LovelyWhite/vst_lan_mic/site/images/product.webp

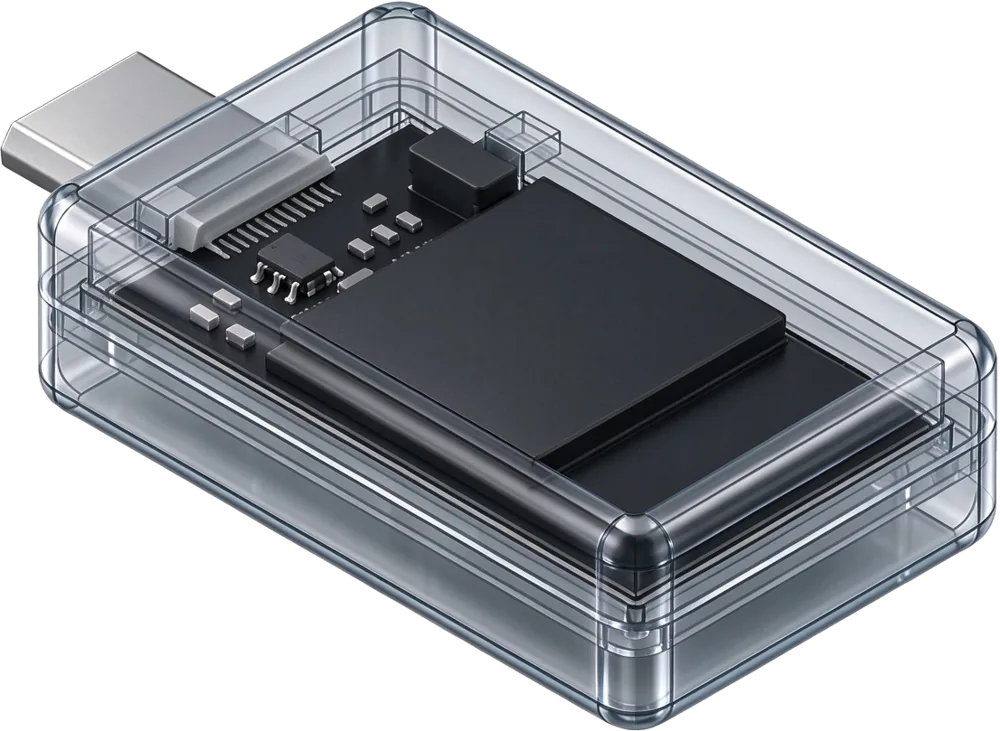
site/images/product.webp
