LovelyWhite/vst_lan_mic/docs/PROTOCOL.md

# 网络协议与线程设计

## 协议版本

唯一的 C++ 协议定义位于 `common/Protocol.h`。固件和插件直接使用同一文件；
`esp32s3/include/Protocol.h` 仅为转发头。Python 发现工具按相同格式读取。

当前版本为 **9**，不兼容版本 8。使用时必须一起更新固件与两个插件。
版本 9 将电脑到 ESP32 的上行从单声道 Opus 改为立体声（交错 L/R）Opus；
版本 8 曾把该方向从 14 ms 单声道 PCM 改为 20 ms 单声道 Opus，并删除
kind 5 Audio。两个方向现在完全同构：48 kHz、立体声（交错 L/R）、
192 kbps CBR，Opus 帧长均为 20 ms / 每声道 960 样本，使用音乐模式，
不使用 Ogg 容器。

## 数据报

所有多字节字段都显式按小端读写，不直接发送 C++ 结构体，不依赖结构体对齐或主机字节序。
固定包头 28 字节。Opus payload 为 1 至 512 字节：两个方向都是 192 kbps CBR
的 20 ms 音频，通常为 480 字节（整包 508 字节），加上 UDP/IPv4 头均远低于
1500 MTU，不需要 IP 分片。

| 偏移 | 字节 | 字段 | 说明 |
| --- | --- | --- | --- |
| 0 | 4 | magic | `0x31534f53`，线上字节为 `SOS1` |
| 4 | 1 | version | `10` |
| 5 | 1 | kind | 1 Discover、2 Offer、3 Subscribe、4 Ack、6 AudioOpus、7 Diagnostics |
| 6 | 2 | flags | Sender=1、Receiver=2、Busy=`0x8000` |
| 8 | 4 | session | 非零会话 ID，Discover 可为零 |
| 12 | 4 | sequence | 每个音频方向独立的包序号，允许自然回绕 |
| 16 | 4 | timestampMs | 发送端单调毫秒计数，允许自然回绕 |
| 20 | 4 | sampleRate | 必须是 48000 |
| 24 | 2 | payloadBytes | 必须与实际 UDP 长度完全匹配 |
| 26 | 2 | reserved | 必须为零 |
| 28 | 可变 | payload | 控制信息或裸 Opus packet |

AudioOpus 用于两个音频方向，必须 flags=0，payloadBytes 为 1 至 512。
两个方向每包都解码为每声道 960 个样本，按 L,R 交错存放（共 1920 个样本）。
Offer 必须 flags=0，负载为 1 至 64 字节 ASCII，形如 `设备标识|设备名称`，不带终止符；
两个字段都不含 `|`，以第一个 `|` 分界。
Discover、Subscribe、Ack 无负载。接收方拒绝错误版本、采样率、长度、保留字段或类型。

## 无串口设备诊断

Diagnostics 是可选扩展，不修改音频包格式。旧插件忽略 kind 7；
新插件连接旧固件时仍能传音频，但面板提示等待诊断。查看设备统计需要更新固件和
Return 插件，不要求更新 Send 插件，也不需要开启 `LANMIC_ENABLE_SERIAL`。

固件在音频发送处理之后，每秒最多从控制端口 45678 向有效 Receiver 的已登记端口
发送一包诊断。复用非阻塞 socket，不新增端口、任务或动态分配；发送失败直接跳过，
不重试、不清除租约、不计入音频发送失败。此统计仍会占用少量网络任务时间和带宽。
包头 flags=0、session=设备开机 ID，sequence 为独立诊断序号，timestampMs 为设备采样
时间，payloadBytes 必须为 64。负载为下表 16 个显式小端 32 位字段，不发送结构体内存：

| 负载偏移 | 字段 | 含义 |
| --- | --- | --- |
| 0 / 4 / 8 | captured / encoded / sent | 累计采集、编码成功、socket 发送成功帧数 |
| 12 / 16 | rawDrop / encodedDrop | 原始、编码队列入队失败次数 |
| 20 / 24 | rawTrim / encodedTrim | 原始、编码队列累计裁剪帧数 |
| 28 | encodeErrors | 累计编码错误次数 |
| 32 / 36 | sendWouldBlock / pollBlocked | 音频发送暂不可用次数、存在待发帧但 socket 不可写次数 |
| 40 | uplinkPlc | 设备解码 DAW 上行时累计补帧数，与 Return PLC 方向不同 |
| 44 / 48 | receiveWorkUs / encodeWorkUs | 收包解码处理、Opus 编码累计墙钟微秒数，包含被抢占时间 |
| 52 / 56 | rawQueued / encodedQueued | 队列帧数快照；原始队列由编码消费者采样 |
| 60 | rssiDbm | 有符号 dBm，范围 -128 至 0；-128 表示未连接 |

除队列快照和 RSSI 外，字段均为设备启动以来的无符号累计值，允许自然回绕。
收包解码处理耗时包括包检查和 PLC，但不包括网络任务的等待；编码耗时不包括开始
编码前的排队。两个耗时不能解释为 CPU 利用率，也不能直接相加计算单核负载。

Return 校验来源 IP、控制端口和开机会话，忽略重复及倒序诊断包，不让诊断包增加
音频 RX/PLC 或刷新音频超时。首包建立基线，之后显示相邻有效快照的计数增量及设备
采样间隔；诊断丢包时窗口自然变长，超过 10 秒则重新建立基线。重连、切换设备、
启停网络和面板上的手动清零会清除基线。`ESP age` 是电脑收到最近有效诊断后经过的时间，达到 3 秒标为
`STALE`，不是网络单程延迟。队列及各阶段计数并非同一瞬间的原子快照，不要求
`cap/enc/sent` 每个窗口完全相等。

排查有声时 PLC 增长：先看 `raw_drop/enc_drop/raw_trim/enc_trim` 是否同时增加。
若增加，说明设备发送前已有丢帧；结合 `RX work/ENC work` 和发送阻塞计数区分处理
负载与发送积压。若这些计数不增加，则继续检查 socket 成功提交之后的传输和电脑接收。
`sent` 仅表示 socket 接收了数据，并不保证电脑收到。

## 发现与订阅

1. 固件监听 UDP 45678（控制）和 45679（上行音频）。
2. 每个插件绑定自己的主临时端口，并为每个有效 IPv4 接口绑定独立的临时发现
   socket，在尚未选中设备时每秒从各接口广播 Discover。设备选中后停止广播和
   网卡端点重建，仅保留单播订阅续约；租约失效后立即恢复发现。Windows 上
   JUCE 8.0.6 无法提供接口定向广播地址，因此各绑定 socket 发送 limited
   broadcast，避免 VPN、虚拟网卡或多网卡让发现包只从错误接口发出。
3. 固件单播 Offer 回请求来源端口，payload 为 `LAN MIC-XXXXXX|设备名称`；`XXXXXX`
   是 eFuse MAC 后 6 位大写十六进制，与 USB 产品名和配网热点编号一致，设备名称
   为可修改的显示名（默认等于设备标识），仅用于展示；`session` 为本次开机随机 ID。
   插件从标识部分提取末 6 位并规范化识别设备（容忍 6 位或 12 位十六进制后缀），
   选择与偏好始终按标识匹配，显示名不参与识别。
4. 插件自动选择最先发现的设备，或选择用户指定身份。DHCP 地址不保存在工程中。
5. 插件每秒向选中设备 45678 发送 Subscribe，flags 为 Sender 或 Receiver，session 为插件实例随机 ID。
6. 固件每方向独立维护 `源 IP + 源端口 + 插件 session` 租约。未占用或原持有者续约时返回 Ack；冲突时 Ack 追加 Busy。
7. 租约自最后一次成功 Subscribe 起 3500 ms 失效。关闭插件或禁用网络后自然超时，不发送广播注销。
8. 固件和插件都识别开机会话变化，重新发现和订阅。多实例不会共用一个电脑固定接收端口。

Sender 向固件 45679 发送音频，session 使用自己的实例 ID，且源端口必须与订阅相同。
Receiver 通过订阅登记接收端口。固件从 45679 向该端口单播音频，session 使用固件开机 ID。
旧的固定电脑下行端口 45680 不再使用。接收插件单独启动也可以获取手机音频，不依赖发送插件。

每台设备同时最多服务一个 Sender 和一个 Receiver。默认自动选择不会遇到 Busy 就抢占或切换其他设备，
避免发送、接收插件无意中连到不同手机；用户可在界面显式选择。

随机 session 用来隔离重启和实例，不是身份认证或安全令牌。
