LovelyWhite/vst_lan_mic/site/images/lan mic return.png

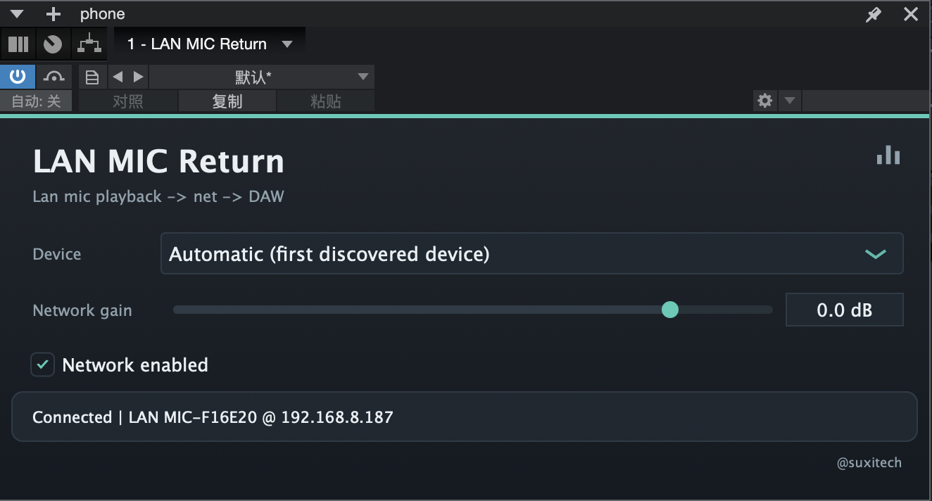
site/images/lan mic return.png
