LovelyWhite/vst_lan_mic/site/images/product.png

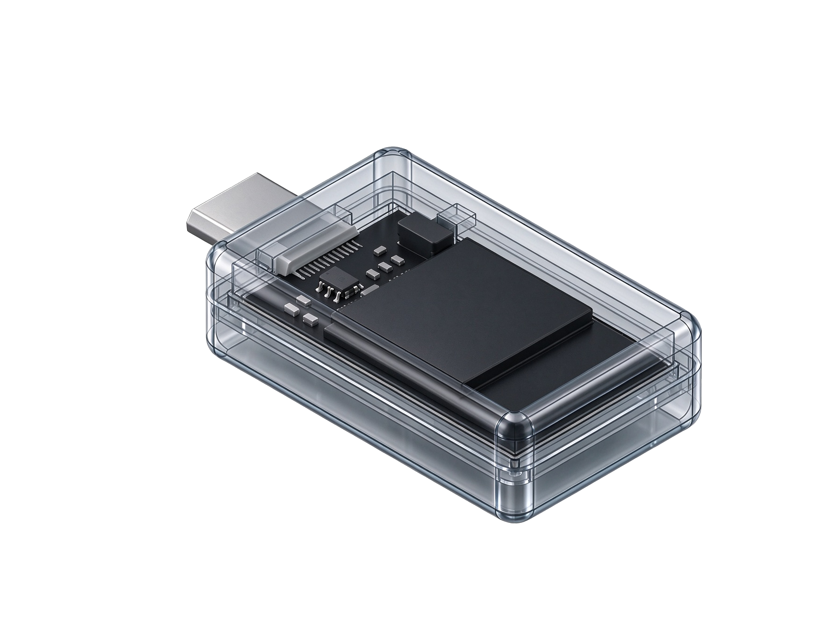
site/images/product.png
