LovelyWhite/vst_lan_mic/enclosure/PCB1_enclosure.FCStd

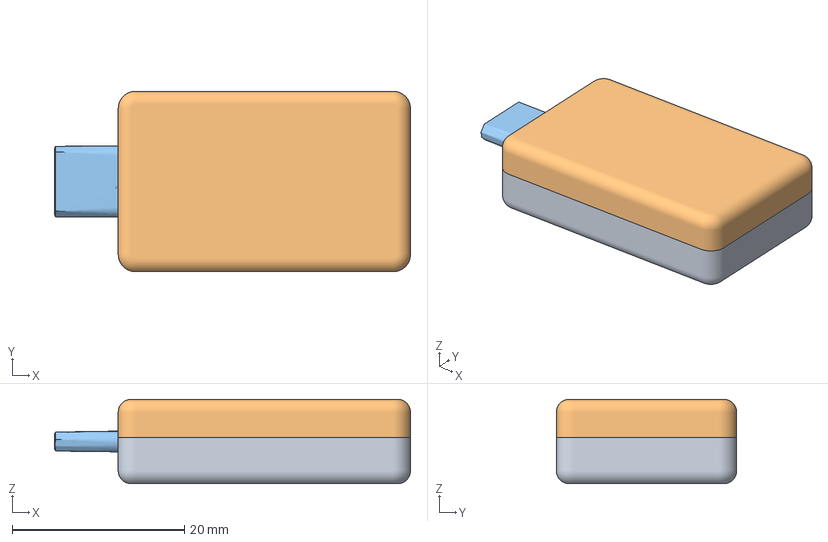
[picture p4: CAD file, 2026-11-14]
enclosure/PCB1_enclosure.FCStd
41.3 x 21.0 x 9.80 mm
Base
Lid
PCB_ref
