LovelyWhite/vst_lan_mic/enclosure/3D_PCB1_2026-11-09.obj

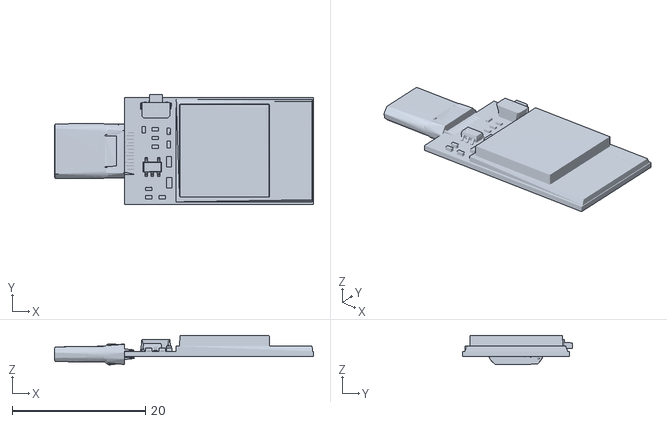
[picture p5: CAD file, 2026-11-09]
enclosure/3D_PCB1_2026-11-09.obj
38.9 x 16.5 x 4.40
