LovelyWhite/vst_lan_mic/(list of files, cad)

Other CAD files:
enclosure/PCB1_enclosure.3mf
