LovelyWhite/vst_lan_mic/vst3/src/Transport.cpp

#include "Transport.h"

#include <opus.h>

namespace {
uint32_t makeSession() {
    const auto n = uint32_t(juce::Random::getSystemRandom().nextInt());
    return n == 0 ? 1 : n;
}
uint32_t nowMs() { return juce::Time::getMillisecondCounter(); }
juce::String normalizedDeviceIdentity(const juce::String& value) {
    const int separator = value.lastIndexOfChar('-');
    if (separator < 0) return {};
    auto number = value.substring(separator + 1).toUpperCase();
    if ((number.length() != 6 && number.length() != 12) ||
        !number.containsOnly("0123456789ABCDEF"))
        return {};
    number = number.substring(number.length() - 6);
    return juce::String(sos::kDeviceName) + "-" + number;
}
constexpr uint32_t kMaxPlcFrames = 300 / sos::kOpusFrameDurationMs;
constexpr uint32_t kMaxOutgoingAgeMs = 300;
constexpr uint32_t kMaxOutgoingBacklogFrames = 32;
constexpr uint32_t kSendCatchupIntervalMs = 6;
constexpr int kMaxSendFramesPerLoop = 1;
}

Transport::Transport(bool sending)
    : Thread(sending ? "LAN MIC Send network" : "LAN MIC Return network"),
      sending_(sending), session_(makeSession()) {
    startThread();
}

Transport::~Transport() {
    signalThreadShouldExit();
    // The worker only waits up to 2 ms on its socket; do not kill it mid-operation.
    stopThread(-1);
}

void Transport::setPreferredDevice(const juce::String& value) {
    const juce::ScopedLock lock(settingsLock_);
    const auto candidate = value.trim().substring(0, 64);
    const auto cleaned = normalizedDeviceIdentity(candidate);
    if (preferred_ == cleaned) return;
    preferred_ = cleaned;
    ++preferenceVersion_;
}

juce::String Transport::preferredDevice() const {
    const juce::ScopedLock lock(settingsLock_);
    return preferred_;
}

std::vector<Transport::Device> Transport::devices() const {
    const juce::ScopedLock lock(settingsLock_);
    return devices_;
}

juce::String Transport::status() const {
    juce::String text;
    switch (state_.load()) {
        case State::Searching:
            text = "Searching on " + juce::String(discoveryInterfaces_.load())
                 + " IPv4 interface(s)";
            break;
        case State::Connecting: text = "Connecting"; break;
        case State::Connected: text = "Connected"; break;
        case State::Busy: text = "Device direction is in use by another instance"; break;
        case State::SocketError: text = "UDP socket error; retrying"; break;
    }
    const juce::ScopedLock lock(settingsLock_);
    if (selected_.isNotEmpty()) text += " | " + selected_;
    return text;
}

void Transport::enqueue(const sos::OpusFrame& pcm, uint32_t now) {
    const Outgoing frame{pcm, now};
    outgoing_.push(&frame, 1);
}

void Transport::invalidateAudio() { ++audioEpoch_; }

void Transport::prepareReceive() {
    const auto epoch = audioEpoch_.load(std::memory_order_acquire);
    if (epoch != consumedEpoch_) {
        incoming_.reset();
        consumedEpoch_ = epoch;
    }
    incoming_.prepare();
}

void Transport::run() {
    int codecStatus = OPUS_OK;
    OpusDecoder* decoder = sending_
        ? nullptr
        : opus_decoder_create(sos::kSampleRate, sos::kOpusChannels, &codecStatus);
    OpusEncoder* encoder = sending_
        ? opus_encoder_create(sos::kSampleRate, int(sos::kOpusChannels),
                              OPUS_APPLICATION_AUDIO, &codecStatus)
        : nullptr;
    if (sending_ && encoder && codecStatus == OPUS_OK) {
        // Mirrors the firmware's downlink encoder profile; CBR keeps every
        // uplink datagram at a predictable 480 bytes.
        codecStatus = opus_encoder_ctl(encoder, OPUS_SET_BITRATE(sos::kOpusBitrate));
        if (codecStatus == OPUS_OK)
            codecStatus = opus_encoder_ctl(encoder, OPUS_SET_VBR(0));
        if (codecStatus == OPUS_OK)
            codecStatus = opus_encoder_ctl(encoder, OPUS_SET_COMPLEXITY(5));
        if (codecStatus == OPUS_OK)
            codecStatus = opus_encoder_ctl(encoder, OPUS_SET_SIGNAL(OPUS_SIGNAL_MUSIC));
    }
    const bool codecReady = sending_
        ? encoder && codecStatus == OPUS_OK
        : decoder && codecStatus == OPUS_OK;
    if (!codecReady) {
        if (decoder) opus_decoder_destroy(decoder);
        if (encoder) opus_encoder_destroy(encoder);
        state_ = State::SocketError;
        return;
    }

    while (!threadShouldExit()) {
        discoveryInterfaces_.store(0);
        juce::DatagramSocket socket(true);
        if (!socket.bindToPort(0)) {
            state_ = State::SocketError;
            wait(500);
            continue;
        }
        struct DiscoveryEndpoint {
            juce::IPAddress directedBroadcast;
            std::unique_ptr<juce::DatagramSocket> socket;
        };
        std::vector<DiscoveryEndpoint> discoveryEndpoints;
        auto rebuildDiscoveryEndpoints = [&] {
            std::vector<DiscoveryEndpoint> rebuilt;
            juce::StringArray boundAddresses;
            for (const auto& address : juce::IPAddress::getAllAddresses()) {
                const auto first = address.address[0];
                if (address.isIPv6 || address.isNull() || first == 0 ||
                    first == 127 || first >= 224)
                    continue;
                const auto text = address.toString();
                if (boundAddresses.contains(text)) continue;
                auto interfaceSocket = std::make_unique<juce::DatagramSocket>(true);
                if (!interfaceSocket->bindToPort(0, text)) continue;
                boundAddresses.add(text);
                rebuilt.push_back({
                    juce::IPAddress::getInterfaceBroadcastAddress(address),
                    std::move(interfaceSocket)
                });
            }
            discoveryEndpoints = std::move(rebuilt);
            discoveryInterfaces_.store(uint32_t(discoveryEndpoints.size()));
        };
        rebuildDiscoveryEndpoints();
        uint32_t version = preferenceVersion_.load();
        juce::String peerIp, preferred = preferredDevice();
        uint32_t peerBoot = 0, selectedAt = 0, lastAck = 0, lastAudio = 0;
        uint32_t lastDiscover = nowMs() - 1000, lastSubscribe = nowMs() - 1000;
        uint32_t lastInterfaceRefresh = nowMs();
        uint32_t nextUplinkSendMs = 0;
        bool wasEnabled = false, haveAck = false, haveAudio = false;
        bool sequenceValid = false;
        uint32_t nextSequence = 0;
        std::array<uint8_t, sos::kMaxPacketSize + 1> packet{};
        sos::OpusFrame decoded{};
        const uint16_t role = sending_ ? sos::Sender : sos::Receiver;

        auto resetStreamState = [&] {
            sequenceValid = false;
            if (decoder) opus_decoder_ctl(decoder, OPUS_RESET_STATE);
            if (encoder) opus_encoder_ctl(encoder, OPUS_RESET_STATE);
        };
        auto clearPeer = [&] {
            outgoing_.clear();
            peerIp.clear();
            peerBoot = 0;
            haveAck = haveAudio = false;
            nextUplinkSendMs = 0;
            state_ = State::Searching;
            resetStreamState();
            invalidateAudio();
            const juce::ScopedLock lock(settingsLock_);
            selected_.clear();
        };
        auto sendControlOn = [&](juce::DatagramSocket& target,
                                 const juce::String& ip,
                                 sos::Kind kind,
                                 uint16_t flags) {
            sos::Header h{kind, flags, session_, 0, nowMs(), 0};
            const auto bytes = int(sos::encode(packet.data(), h));
            if (target.waitUntilReady(false, 0) == 1)
                target.write(ip, sos::kDiscoveryPort, packet.data(), bytes);
        };
        auto sendControl = [&](const juce::String& ip, sos::Kind kind, uint16_t flags) {
            sendControlOn(socket, ip, kind, flags);
        };
        auto handleOffer = [&](const sos::Header& h,
                               const juce::String& source,
                               int port,
                               uint32_t now) {
            if (h.kind != sos::Kind::Offer || port != sos::kDiscoveryPort)
                return false;
            const auto raw = juce::String::fromUTF8(
                reinterpret_cast<const char*>(packet.data() + sos::kHeaderSize),
                h.payloadBytes);
            // v10 payload is "identity|display name"; the pipe cannot appear in
            // either field, so the first one is the separator.
            const auto separator = raw.indexOfChar('|');
            const auto identity = normalizedDeviceIdentity(
                separator < 0 ? raw : raw.substring(0, separator));
            if (identity.isEmpty()) return true;
            auto display = separator < 0 ? juce::String{}
                                         : raw.substring(separator + 1).trim();
            if (display.isEmpty()) display = identity;
            {
                const juce::ScopedLock lock(settingsLock_);
                auto found = std::find_if(devices_.begin(), devices_.end(),
                    [&](const Device& d) { return d.identity == identity; });
                if (found != devices_.end()) *found = {identity, display, source, now};
                else if (devices_.size() < 32)
                    devices_.push_back({identity, display, source, now});
            }
            if (peerIp.isEmpty() && (preferred.isEmpty() || preferred == identity)) {
                peerIp = source;
                peerBoot = h.session;
                selectedAt = now;
                lastSubscribe = now - 1000;
                state_ = State::Connecting;
                const juce::ScopedLock lock(settingsLock_);
                selected_ = display + " @ " + source;
            } else if (source == peerIp) {
                if (h.session != peerBoot) {
                    clearPeer(); // Reboot: require discovery and a fresh lease.
                } else {
                    // Keep the status text in sync with a renamed device.
                    const juce::ScopedLock lock(settingsLock_);
                    selected_ = display + " @ " + source;
                }
            }
            return true;
        };
        clearPeer();

        while (!threadShouldExit()) {
            const auto now = nowMs();
            const bool enabled = enabled_.load(std::memory_order_acquire);
            const auto newVersion = preferenceVersion_.load();
            if (newVersion != version) {
                version = newVersion;
                preferred = preferredDevice();
                clearPeer();
                lastDiscover = now - 1000;
            }
            if (enabled != wasEnabled) {
                outgoing_.clear();
                haveAck = haveAudio = false;
                resetStreamState();
                invalidateAudio();
                state_ = peerIp.isEmpty() ? State::Searching : State::Connecting;
                selectedAt = now;
                lastSubscribe = now - 1000;
                nextUplinkSendMs = 0;
                wasEnabled = enabled;
            }
            if (peerIp.isNotEmpty() && enabled &&
                uint32_t(now - (haveAck ? lastAck : selectedAt)) >= sos::kLeaseMs) {
                clearPeer();
            }
            if (haveAudio && uint32_t(now - lastAudio) >= sos::kAudioTimeoutMs) {
                haveAudio = false;
                resetStreamState();
                invalidateAudio();
            }
            // Discovery and stale-device pruning must keep running while a peer
            // is connected: devices answer Discover reactively, so pausing it
            // would freeze the device list for the whole session.
            if (uint32_t(now - lastInterfaceRefresh) >= 5000) {
                lastInterfaceRefresh = now;
                rebuildDiscoveryEndpoints();
            }
            if (uint32_t(now - lastDiscover) >= 1000) {
                lastDiscover = now;
                // Windows cannot obtain directed broadcasts through JUCE 8.0.6.
                // A socket bound to each local address forces limited broadcast
                // onto every eligible adapter and receives the unicast Offer.
                sendControl("255.255.255.255", sos::Kind::Discover, 0);
                for (auto& endpoint : discoveryEndpoints) {
                    sendControlOn(*endpoint.socket, "255.255.255.255",
                                  sos::Kind::Discover, 0);
                    if (!endpoint.directedBroadcast.isNull() &&
                        endpoint.directedBroadcast != juce::IPAddress::broadcast()) {
                        sendControlOn(*endpoint.socket,
                                      endpoint.directedBroadcast.toString(),
                                      sos::Kind::Discover, 0);
                    }
                }
                const juce::ScopedLock lock(settingsLock_);
                devices_.erase(std::remove_if(devices_.begin(), devices_.end(),
                    [now](const Device& d) { return uint32_t(now - d.seenMs) >= 5000; }),
                    devices_.end());
            }
            if (enabled && peerIp.isNotEmpty() && uint32_t(now - lastSubscribe) >= 1000) {
                lastSubscribe = now;
                sendControl(peerIp, sos::Kind::Subscribe, role);
            }

            for (auto& endpoint : discoveryEndpoints) {
                for (int n = 0;
                     n < 8 && endpoint.socket->waitUntilReady(true, 0) == 1;
                     ++n) {
                    juce::String source;
                    int port = 0;
                    const int bytes = endpoint.socket->read(
                        packet.data(), int(packet.size()), false, source, port);
                    sos::Header h;
                    if (bytes > 0 && sos::decode(packet.data(), size_t(bytes), h))
                        handleOffer(h, source, port, now);
                }
            }

            const int ready = socket.waitUntilReady(true, 2);
            if (ready < 0) {
                clearPeer();
                state_ = State::SocketError;
                break;
            }
            for (int n = 0; n < 32 && socket.waitUntilReady(true, 0) == 1; ++n) {
                juce::String source;
                int port = 0;
                const int bytes = socket.read(packet.data(), int(packet.size()), false, source, port);
                sos::Header h;
                if (bytes <= 0 || !sos::decode(packet.data(), size_t(bytes), h)) continue;
                if (handleOffer(h, source, port, now)) {
                    // Discovery responses may arrive on the main fallback socket.
                } else if (h.kind == sos::Kind::Ack && source == peerIp &&
                           port == sos::kDiscoveryPort && h.session == session_ &&
                           (h.flags & ~sos::Busy) == role && enabled) {
                    lastAck = now;
                    haveAck = true;
                    const bool busy = (h.flags & sos::Busy) != 0;
                    if (busy && state_.load() != State::Busy) {
                        resetStreamState();
                        invalidateAudio();
                    }
                    state_ = busy ? State::Busy : State::Connected;
                } else if (!sending_ && enabled && connected() &&
                           h.kind == sos::Kind::AudioOpus &&
                           source == peerIp && port == sos::kUplinkPort && h.session == peerBoot) {
                    uint32_t gap = 0;
                    if (sequenceValid) {
                        gap = h.sequence - nextSequence;
                        if (gap >= 0x80000000u) {
                            continue; // Duplicate or late packet.
                        }
                    }
                    if (gap > kMaxPlcFrames)
                        opus_decoder_ctl(decoder, OPUS_RESET_STATE);

                    bool decodeOk = true;
                    const uint32_t plcFrames = std::min(gap, kMaxPlcFrames);
                    for (uint32_t i = 0; i < plcFrames; ++i) {
                        // opus_decode counts per-channel samples; the queue
                        // consumes the interleaved L/R pairs it emits.
                        const int samples = opus_decode(
                            decoder, nullptr, 0, decoded.data(),
                            int(sos::kOpusFrameSamples), 0);
                        if (samples != int(sos::kOpusFrameSamples)) {
                            decodeOk = false;
                            break;
                        }
                        if (!incoming_.queue.push(decoded.data(),
                                uint32_t(samples) * sos::kOpusChannels)) {
                            incoming_.overflows.fetch_add(1, std::memory_order_relaxed);
                        }
                    }

                    const int samples = decodeOk
                        ? opus_decode(decoder, packet.data() + sos::kHeaderSize,
                                      h.payloadBytes, decoded.data(),
                                      int(sos::kOpusFrameSamples), 0)
                        : OPUS_INTERNAL_ERROR;
                    if (samples != int(sos::kOpusFrameSamples)) {
                        resetStreamState();
                        invalidateAudio();
                        continue;
                    }
                    if (!incoming_.queue.push(decoded.data(),
                            uint32_t(samples) * sos::kOpusChannels)) {
                        // The audio consumer trims backlog without clearing its priming buffer.
                        incoming_.overflows.fetch_add(1, std::memory_order_relaxed);
                    }
                    nextSequence = h.sequence + 1;
                    sequenceValid = true;
                    lastAudio = now;
                    haveAudio = true;
                }
            }

            if (sending_) {
                // Send-time sequence assignment: a frame dropped here (stale,
                // disconnected, disabled) or in enqueue (queue full) never
                // burns a number, so sender-side trimming can never masquerade
                // as packet loss and the receiver only ever sees gaps from the
                // network itself. The network thread keeps the larger queue
                // bounded by dropping old backlog, then sends at a controlled
                // catch-up pace so the ESP32 socket drain is not hit by bursts.
                const uint32_t sendNow = nowMs();
                if (!enabled || !connected()) {
                    outgoing_.clear();
                    nextUplinkSendMs = sendNow;
                } else {
                    const auto backlog = outgoing_.size();
                    if (backlog > kMaxOutgoingBacklogFrames)
                        outgoing_.discard(backlog - kMaxOutgoingBacklogFrames);

                    if (int32_t(sendNow - nextUplinkSendMs) >= 0 &&
                        socket.waitUntilReady(false, 0) == 1) {
                        Outgoing frame;
                        for (int budget = kMaxSendFramesPerLoop;
                             budget > 0 && outgoing_.pop(frame);
                             --budget) {
                            if (uint32_t(sendNow - frame.timeMs) > kMaxOutgoingAgeMs)
                                continue;
                            const int encoded = opus_encode(
                                encoder, frame.pcm.data(), int(sos::kOpusFrameSamples),
                                packet.data() + sos::kHeaderSize, int(sos::kOpusMaxBytes));
                            if (encoded <= 0) {
                                resetStreamState();
                                continue;
                            }
                            sos::Header h{sos::Kind::AudioOpus, 0, session_,
                                          sendSequence_++, frame.timeMs,
                                          uint16_t(encoded)};
                            const auto bytes = int(sos::encode(packet.data(), h));
                            socket.write(peerIp, sos::kUplinkPort, packet.data(), bytes);
                            nextUplinkSendMs = sendNow + kSendCatchupIntervalMs;
                        }
                    }
                }
            }
        }
        invalidateAudio();
        if (!threadShouldExit()) wait(100);
    }
    discoveryInterfaces_.store(0);
    if (decoder) opus_decoder_destroy(decoder);
    if (encoder) opus_encoder_destroy(encoder);
}
