LovelyWhite/vst_lan_mic/common/AudioBuffer.h

#pragma once

#include "Protocol.h"
#include <algorithm>
#include <atomic>
#include <cmath>

namespace sos {
// One producer and one consumer. Only the consumer may discard queued data.
template <typename T, uint32_t Capacity>
class SpscRing {
public:
    static_assert((Capacity & (Capacity - 1)) == 0, "Capacity must be a power of two");
#if !defined(ARDUINO_ARCH_ESP32)
    // Keep DAW callbacks lock-free. ESP32 permits the SDK's atomic fallback:
    // is_always_lock_free == false does not invalidate acquire/release semantics.
    static_assert(std::atomic<uint32_t>::is_always_lock_free, "Lock-free counters required");
#endif
    uint32_t size() const {
        const auto r = read_.load(std::memory_order_acquire);
        return write_.load(std::memory_order_acquire) - r;
    }
    bool push(const T* data, uint32_t count) {
        const auto w = write_.load(std::memory_order_relaxed);
        if (count > Capacity - (w - read_.load(std::memory_order_acquire))) return false;
        for (uint32_t i = 0; i < count; ++i) data_[(w + i) & (Capacity - 1)] = data[i];
        write_.store(w + count, std::memory_order_release);
        return true;
    }
    // Consumer-only preview; the producer cannot reuse this slot until discard/pop.
    bool peek(T& result) const {
        const auto r = read_.load(std::memory_order_relaxed);
        if (r == write_.load(std::memory_order_acquire)) return false;
        result = data_[r & (Capacity - 1)];
        return true;
    }
    bool pop(T& result) {
        const auto r = read_.load(std::memory_order_relaxed);
        if (r == write_.load(std::memory_order_acquire)) return false;
        result = data_[r & (Capacity - 1)];
        read_.store(r + 1, std::memory_order_release);
        return true;
    }
    void discard(uint32_t count) {
        const auto r = read_.load(std::memory_order_relaxed);
        count = std::min(count, write_.load(std::memory_order_acquire) - r);
        read_.store(r + count, std::memory_order_release);
    }
    void clear() { discard(Capacity); }
private:
    std::array<T, Capacity> data_{};
    std::atomic<uint32_t> read_{0}, write_{0};
};

inline int16_t pcm16(float value) {
    if (!std::isfinite(value)) return 0;
    return int16_t(std::max(-32768.0f, std::min(32767.0f, value * 32768.0f)));
}

// Consumer-side elastic playout. A small continuous rate correction compensates
// independent USB/DAW clocks; hard trimming bounds latency after a long stall.
// The queue holds interleaved samples: mono (Channels == 1) or stereo L,R pairs
// (Channels == 2). Both channels share one interpolation phase and one fade so
// L/R never decorrelate — independent ramps would smear the image and can crack.
template <int Channels>
class Playout {
public:
    static_assert(Channels == 1 || Channels == 2,
                  "Playout supports mono or interleaved stereo");
#if defined(ARDUINO_ARCH_ESP32)
    // Opus keeps the Wi-Fi/lwIP load low enough to restore the full stability
    // buffer while retaining more than 100 KB of measured internal heap.
    static constexpr size_t frameCapacity = 32768;
    static constexpr uint32_t targetMs = 300;
    static constexpr float maxRateCorrection = 0.002f;
#else
    // Favor duplex monitoring stability; leave room above target for receive bursts.
    static constexpr size_t frameCapacity = 65536;
    static constexpr uint32_t targetMs = 300;
    static constexpr float maxRateCorrection = 0.002f;
#endif
    // Queue lengths are in interleaved samples; targets stay in milliseconds
    // when the protocol frame duration changes.
    static constexpr size_t queueCapacity = frameCapacity * size_t(Channels);
    static constexpr uint32_t targetFrames =
        (targetMs + kOpusFrameDurationMs - 1) / kOpusFrameDurationMs;
    static constexpr uint32_t target =
        targetFrames * kOpusFrameSamples * uint32_t(Channels);
    // Latency bound for the elastic path. The rate correction drains only
    // ~0.2 samples/ms, so a 300 ms excess needs minutes to recover: without a
    // high-water trim every network stall ratchets playout latency up for good.
    static constexpr uint32_t highWater =
        target + uint32_t(kSampleRate) / 1000 * 150 * uint32_t(Channels);
    static_assert(target + kOpusFrameSamples * uint32_t(Channels) < queueCapacity,
                  "Playout queue is too small");
    static_assert(highWater < queueCapacity, "High-water trim must leave headroom");
    SpscRing<int16_t, queueCapacity> queue;
    // Functional backpressure signal: prepare() trims when it differs from
    // handledOverflows_; not a display counter.
    std::atomic<uint32_t> overflows{0};

    // Pushes one whole Opus frame. The size check keeps a frame built for the
    // other channel count from being queued half-at-a-time, which would play
    // back at the wrong pitch instead of failing.
    template <size_t N>
    void push(const std::array<int16_t, N>& frame) {
        static_assert(N == kOpusFrameSamples * size_t(Channels),
                      "Frame must match this playout's channel count");
        if (!queue.push(frame.data(), uint32_t(frame.size()))) ++overflows;
    }
    void setNominalRatio(float ratio) {
        nominalRatio_ = std::max(0.125f, std::min(8.0f, ratio));
        ratio_ = nominalRatio_;
    }
    void reset() {
        queue.clear();
        primed_ = false;
        phase_ = 0;
        ratio_ = nominalRatio_;
        for (int ch = 0; ch < Channels; ++ch) previous_[ch] = 0;
        fade_ = 0;
    }
    void prepare() {
        const auto size = queue.size();
        const auto overflowCount = overflows.load(std::memory_order_relaxed);
        if (size > target &&
            (size > highWater || overflowCount != handledOverflows_)) {
            // Only the consumer trims; retain a priming buffer after producer overflow.
            const auto discard = (size - target) / Channels * Channels;
            queue.discard(discard);
            primed_ = false;
        }
        handledOverflows_ = overflowCount;
        const float correction = std::max(-maxRateCorrection,
            std::min(maxRateCorrection,
                (float(queue.size()) - float(target)) * 0.000002f));
        const float desired = nominalRatio_ * (1.0f + correction);
        ratio_ += (desired - ratio_) * 0.02f;
    }
    // Writes Channels interleaved floats (out[0] = L, out[1] = R when stereo).
    void next(float* out) {
        if (!primed_) {
            if (queue.size() < target) {
                for (int ch = 0; ch < Channels; ++ch) {
                    previous_[ch] = std::abs(previous_[ch]) < 0.000001f
                        ? 0.0f : previous_[ch] * 0.98f;
                    out[ch] = previous_[ch];
                }
                return;
            }
            for (int ch = 0; ch < Channels; ++ch) queue.pop(a_[ch]);
            for (int ch = 0; ch < Channels; ++ch) queue.pop(b_[ch]);
            phase_ = 0;
            primed_ = true;
            fade_ = 0;
            for (int ch = 0; ch < Channels; ++ch) fadeFrom_[ch] = previous_[ch];
        }
        for (int ch = 0; ch < Channels; ++ch)
            out[ch] = (float(a_[ch]) + (float(b_[ch]) - float(a_[ch])) * phase_) /
                      32768.0f;
        fade_ = std::min(1.0f, fade_ + 1.0f / 96.0f);
        for (int ch = 0; ch < Channels; ++ch)
            out[ch] = fadeFrom_[ch] * (1.0f - fade_) + out[ch] * fade_;
        phase_ += ratio_;
        while (phase_ >= 1.0f) {
            phase_ -= 1.0f;
            for (int ch = 0; ch < Channels; ++ch) a_[ch] = b_[ch];
            bool starved = false;
            // Interleaved order: popping the L sample must be followed by its
            // R partner, so a failed pop always ends the advance for all.
            for (int ch = 0; ch < Channels; ++ch)
                if (!queue.pop(b_[ch])) starved = true;
            if (starved) {
                primed_ = false;
                break;
            }
        }
        for (int ch = 0; ch < Channels; ++ch) previous_[ch] = out[ch];
    }
private:
    bool primed_ = false;
    int16_t a_[Channels] = {}, b_[Channels] = {};
    float phase_ = 0, nominalRatio_ = 1, ratio_ = 1;
    float previous_[Channels] = {}, fadeFrom_[Channels] = {}, fade_ = 0;
    uint32_t handledOverflows_ = 0;
};
using StereoPlayout = Playout<2>;
} // namespace sos
