LovelyWhite/vst_lan_mic/common/Protocol.h

#pragma once

#include <array>
#include <cstddef>
#include <cstdint>

namespace sos {
constexpr uint32_t kMagic = 0x31534f53;
// v10: the Offer payload became "identity|device name"; v9 made the DAW-to-device
// uplink stereo Opus; v8 carried it as mono Opus and v7 as 14 ms mono PCM
// (kind Audio, removed).
constexpr uint8_t kVersion = 10;
constexpr uint16_t kDiscoveryPort = 45678;
constexpr uint16_t kUplinkPort = 45679;
constexpr uint32_t kSampleRate = 48000;
// Both directions frame Opus at 20 ms / 960 samples per channel, keeping the
// complete IPv4 datagram below the 1500-byte Ethernet/Wi-Fi MTU.
constexpr size_t kOpusFrameSamples = 960;
constexpr size_t kOpusChannels = 2;
constexpr uint32_t kOpusFrameDurationMs = 20;
// Stereo 192 kbps CBR over 20 ms is 480 bytes, still well inside the MTU.
// Both directions share this profile.
constexpr int kOpusBitrate = 192000;
constexpr size_t kOpusMaxBytes = 512;
constexpr size_t kHeaderSize = 28;
constexpr size_t kMaxPacketSize = kHeaderSize + kOpusMaxBytes;
constexpr uint32_t kLeaseMs = 3500;
constexpr uint32_t kAudioTimeoutMs = 500;
constexpr const char* kDeviceName = "LAN MIC";

enum class Kind : uint8_t {
    Discover = 1, Offer = 2, Subscribe = 3, Ack = 4, AudioOpus = 6
};
enum Role : uint16_t { Sender = 1, Receiver = 2, Busy = 0x8000 };

inline uint16_t get16(const uint8_t* p) {
    return uint16_t(p[0]) | (uint16_t(p[1]) << 8);
}
inline uint32_t get32(const uint8_t* p) {
    return uint32_t(get16(p)) | (uint32_t(get16(p + 2)) << 16);
}
inline void put16(uint8_t* p, uint16_t v) {
    p[0] = uint8_t(v); p[1] = uint8_t(v >> 8);
}
inline void put32(uint8_t* p, uint32_t v) {
    put16(p, uint16_t(v)); put16(p + 2, uint16_t(v >> 16));
}

struct Header {
    Kind kind = Kind::Discover;
    uint16_t flags = 0;
    uint32_t session = 0;
    uint32_t sequence = 0;
    uint32_t timestampMs = 0;
    uint16_t payloadBytes = 0;
};

inline size_t encode(uint8_t* p, const Header& h) {
    put32(p, kMagic);
    p[4] = kVersion;
    p[5] = uint8_t(h.kind);
    put16(p + 6, h.flags);
    put32(p + 8, h.session);
    put32(p + 12, h.sequence);
    put32(p + 16, h.timestampMs);
    put32(p + 20, kSampleRate);
    put16(p + 24, h.payloadBytes);
    put16(p + 26, 0);
    return kHeaderSize + h.payloadBytes;
}

inline bool decode(const uint8_t* p, size_t size, Header& h) {
    if (size < kHeaderSize || size > kMaxPacketSize ||
        get32(p) != kMagic || p[4] != kVersion ||
        get32(p + 20) != kSampleRate || get16(p + 26) != 0 ||
        p[5] < uint8_t(Kind::Discover) || p[5] > uint8_t(Kind::AudioOpus))
        return false;
    h = {Kind(p[5]), get16(p + 6), get32(p + 8), get32(p + 12),
         get32(p + 16), get16(p + 24)};
    if (size != kHeaderSize + h.payloadBytes) return false;
    switch (h.kind) {
        case Kind::AudioOpus:
            return h.flags == 0 && h.session != 0 &&
                   h.payloadBytes > 0 && h.payloadBytes <= kOpusMaxBytes;
        case Kind::Offer:
            return h.flags == 0 && h.session != 0 &&
                   h.payloadBytes > 0 && h.payloadBytes <= 64;
        case Kind::Subscribe:
            return (h.flags == Sender || h.flags == Receiver) &&
                   h.session != 0 && h.payloadBytes == 0;
        case Kind::Ack:
            return ((h.flags & ~Busy) == Sender || (h.flags & ~Busy) == Receiver) &&
                   h.session != 0 && h.payloadBytes == 0;
        case Kind::Discover:
            return h.flags == 0 && h.payloadBytes == 0;
    }
    return false;
}

// Both directions carry interleaved stereo (L,R); one frame holds a single
// 20 ms Opus packet's samples for both channels.
using OpusFrame = std::array<int16_t, kOpusFrameSamples * kOpusChannels>;
} // namespace sos
