LovelyWhite/vst_lan_mic/(commit log)

2026-10-18 fix: windows can not search device
    [Transport.cpp, Transport.h]
2026-10-19 fix(usb-audio): 修复iOS UAC2播放音量控制异常与爆音问题
    将UAC标准的-100~0dB音量刻度正确转换为听感均匀的振幅增益，而非直接使用归一化控制值
    为音量调节添加约5ms的平滑处理，避免阶跃爆音
    仅响应手机播放链路的音量/静音请求，忽略麦克风链路的控制
    降低音频库日志级别，解决串口日志阻塞实时音频处理的问题
    更新PROTOCOL.md、VALIDATION.md、README.md及调试文档，补充相关说明与测试项
    [main.cpp]
2026-10-19 fix(audio-compensation): 修复短PCM丢包引发的音量凹陷卡顿
    为1~2帧的短PCM丢包添加端点连续桥接逻辑，替代原有的淡出静音补偿流程，避免约28ms的可闻音量凹陷；保留长缺口的原有300ms补偿策略。
    更新README、PROTOCOL.md与VALIDATION.md文档，补充新的丢包处理说明与测试验证项。
    新增bridged与upBridge调试统计指标，更新串口调试日志输出。
    新增debug-daw-phone-stutter.md文档，记录本次问题的分析与修复全过程。
    [AudioBuffer.h, main.cpp]
2026-10-20 fix: 修复5秒周期卡顿与音频爆音，完善接收器插件行为
    - 仅在未连接对等设备时执行网卡发现与接口刷新，避免每5秒阻塞网络线程引发固定周期卡顿
    - 将短丢包间隙的线性桥接替换为smoothstep平滑淡入淡出曲线，消除端点样本差异导致的低频爆音
    - 将esp2vst标记为VST3生成器插件，确保宿主在无输入音频时仍持续处理该插件
    - 重构接收器插件的参数回调、准备播放与状态恢复逻辑，支持无编辑器自动连接接收音频
    - 优化ESP32调试日志输出时机，仅在USB音频空闲时打印完整快照，避免干扰实时任务
    - 更新所有文档与测试用例，匹配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
    [AudioBuffer.h, PluginProcessor.cpp, PluginProcessor.h, Transport.cpp, main.cpp]
2026-10-20 refactor: 统一项目与插件品牌命名，兼容新旧设备识别
    - 全局替换项目品牌标识从SUXITECH LAN MIC为LAN MIC
    - 重命名VST3插件：vst2esp → LAN MIC Send，esp2vst → LAN MIC Return
    - 新增设备标识规范化处理函数，兼容6/12位十六进制设备后缀
    - 更新所有文档、配置文件与调试记录中的相关命名
    - 补充VSCode的C++标准库头文件补全配置
2026-10-20 feat(esp32s3): 优化WiFi配置功能与界面文案
    - 更新platformio编译配置：添加include目录搜索路径，定义WM_STRINGS_FILE宏
    - 移除main.cpp中硬编码的WiFiManager自定义HTML头部，改用自定义字符串文件
    - 调整WiFiManager参数：缩短连接超时至6秒，添加根路径重定向，设置页面标题为LAN MIC
    - 新增自定义字符串文件my_strings_en.h，替换WiFiManager默认文案
    - 修复VSCode配置文件，补充头文件关联与包含路径
    [main.cpp, my_strings_en.h]
2026-10-27 feat: 新增GPIO18状态指示灯，调整编译配置并更新文档
    - 调整ESP32-S3编译配置：将闪存大小改为4MB，分区表切换为ota_nofs_4MB，内存类型改为qio_qspi，并同步更新VSCode配置路径
    - 实现状态灯控制任务，支持多场景指示灯模式：配网热点开启时慢闪、WiFi连接中快闪、音频传输时每秒短灭、初始化错误时双闪、长按BOOT按键后的极快闪
    - 更新README文档，添加状态灯接线说明、电平配置参数及各状态含义
    - 更新VALIDATION.md校验清单，新增状态灯检查项
    - 补充VSCode配置中的C++头文件映射，添加random头文件关联
2026-10-27 fix(esp32s3): 将Opus编码器状态移至PSRAM以节省内部堆空间
    更新所有文档以匹配编码器存储位置的变更，修复VSCode头文件搜索路径，新增PSRAM监控指标要求
2026-10-27 perf(networkTask): 优化网络任务CPU占用，降低空转损耗
    限制栈高水位标记采样频率为500ms，避免高频扫描消耗CPU；无活跃连接时调整任务延时至5ms
2026-10-27 feat(protocol, vst3, docs): 升级协议至v7，支持下行立体声音频传输
    将全局协议版本从6升级至7，旧版本组件将被明确拒绝连接。
    下行（手机→DAW）音频改为交错立体声格式，保留原始左右声道分离，不再混音为单声道。
    重构VST3接收插件的音频处理逻辑，适配立体声采样的接收与多声道布局分发。
    更新所有相关文档、UI提示文本与配置常量，同步修改Python发现工具的协议版本。
    优化音频播放队列模板，支持单声道和立体声两种模式，统一声道插值与淡入淡出逻辑。
    上行（DAW→手机）仍保持单声道PCM传输，维持原有兼容性。
2026-10-27 Revert "fix(esp32s3): 将Opus编码器状态移至PSRAM以节省内部堆空间"
    This reverts commit bff2ef6ad35e262c8351bb2312b121988f16406b.
    [main.cpp]
2026-10-27 perf(esp32s3): 调整opus编码器复杂度至4以降低CPU负载
2026-10-27 perf(esp32s3): 添加SOS_METRICS宏以控制调试指标代码编译
    默认将宏值设为0，会移除1kHz音频和网络循环中的调试代码以节省CPU资源；可通过-DSOS_METRICS=1编译选项重新启用所有调试统计功能。
2026-10-27 fix(vst3): 修复设备列表残留无效条目且连接后无法更新的问题
    调整设备发现与刷新逻辑，移除仅在未连接时运行发现的限制，添加注释说明避免幽灵设备残留。
2026-10-28 perf(esp32s3): 优化电源管理并降低任务空转开销
    新增USB音频流空闲超时后自动启用WiFi调制解调器休眠的逻辑，仅在流传输期间保持WiFi唤醒以降低待机功耗。为状态LED、音频和网络任务添加动态延时策略，根据运行状态调整调度间隔，减少不必要的CPU空转。移除硬编码的WiFi强制唤醒配置，改用ESP-IDF默认休眠模式并由音频任务按需控制。
2026-10-29 docs(debug docs): 删除两份已归档的调试会话文档
    移除debug-daw-phone-stutter.md和debug-audio-crackle-stability.md这两份已完成的音频调试记录，清理代码库中的冗余文档。
2026-10-30 fix(audio,transport,esp32s3): 优化音频传输，修复卡顿爆音与USB异常
    - 重构VST3 Transport的音频发送逻辑，移除nextAudioSend定时变量，改为FIFO批量发送最多8个队列中的包，避免接收器将发送方的backlog修剪误判为丢包
    - 优化SequenceTracker的音频间隙补偿算法：短间隙使用线性插值替代平滑曲线，避免爆音；宽间隙使用1ms淡入淡出替代全帧淡入，减少爆音现象
    - 修复ESP32-S3固件的USB流活跃检测逻辑，改用传输完成计数替代不可靠的isStreamingActiveTx接口，解决USB流假死问题
    - 增大ESP32-S3的USB FIFO大小从16到48包，提升缓冲能力以应对调度抖动
    - 调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
    [AudioBuffer.h, Transport.cpp, main.cpp]
2026-10-30 refactor(vst3, common): 优化音频间隙补偿逻辑并清理冗余代码
    - 统一在传输线程内管理发送序列号,移除处理器与传输层间冗余的序列号传递逻辑
    - 重构音频序列追踪器的间隙补偿逻辑,新增斜率限制与平滑淡入效果以避免爆音
    - 清理编辑器中未使用的提示标签,更新UI方向文本为更准确的内容
    - 调整数据包发送预算从8增至16以优化发送效率
    - 移除多处未使用的变量和函数参数
2026-10-30 feat: 新增LAN MIC全套安装工具与官方网站
    添加跨平台VST3插件安装脚本与安装包打包工具，新增项目官方静态网站与插件界面截图；优化插件编辑器UI，移除无用的hint提示组件；更新.gitignore忽略构建产物与临时文件，补全ESP32-S3项目的VSCode C++头文件补全列表。
2026-10-30 docs: 更新网站内容并添加 v0.1.0 版本发布包
    新增版本发布包：LANMIC_0.1.0.pkg（macOS）和 LANMIC_Setup_0.1.0.exe（Windows）
    调整首页标题和行动按钮布局
    更新设备连接说明和指示灯状态指南
    调换购买和首次使用的提示内容
    将旧下载链接替换为带版本号的文件名
    移除未使用的工程保存配置功能卡片
2026-10-31 feat: 升级协议至v8，替换上行链路为Opus编码
    - 将电脑到ESP32的上行链路从14ms单声道PCM改为20ms单声道Opus 128kbps CBR，统一上下行帧时长为20ms/每声道960样本
    - 协议版本升级至8，不再兼容v7及更早版本，移除了旧的Audio音频包类型
    - 更新ESP32固件与VST3插件的编解码逻辑，添加上行Opus编码与双向丢包补偿机制
    - 调整ESP32闪存配置为qio_opi，更新项目配置文件与.gitignore忽略规则
    - 更新所有文档、README与网站说明，修正延迟与参数描述
    - 删除了过时的Python设备发现脚本
    [AudioBuffer.h, Protocol.h, Transport.cpp, main.cpp]
2026-10-31 chore: 移除已跟踪的 .vscode 配置文件
    ignore 规则对已跟踪文件不生效，从索引中删除以恢复排除
2026-10-31 refactor(vst3): 简化UI与传输逻辑，调整Opus编码参数
    移除PluginEditor中的流量统计标签组件及相关更新、布局代码，调整编辑器窗口尺寸以适配新UI
    将Opus编码器复杂度从4调整为10，提升音频编码质量
    删除Transport层的冗余流量统计计数器及相关计数逻辑
    简化传输层的错误处理流程
2026-10-31 perf(esp32s3): 优化任务调度与编译配置，提升实时性
    - 新增Pacer类实现精确周期定时，消除vTaskDelay的累积延迟漂移，无需硬编码Tick速率
    - 调整编译优化为-O2，添加OPUS编解码的固定点编译相关配置
    - 交换音频与网络任务的CPU核心绑定，减少核心竞争
    - 升级C++标准至gnu++17
2026-10-31 feat(esp32s3): 新增调试统计追踪与周期性上报功能
    新增统一的DebugStats统计结构体，支持追踪任务调度超期次数、循环最大耗时、队列丢包、UDP发送失败等多类运行时指标；添加原子操作辅助函数更新最大/最小值统计；在音频和网络任务中插入统计更新点，在loop任务中实现每秒输出一次CSV格式的统计数据；同时修改任务创建逻辑以保存任务句柄，用于查询栈高水位。
2026-11-01 perf(esp32s3): 优化network任务调度，改用事件驱动下行发送
    新增Pacer类的waitNotify方法，支持任务通知提前唤醒，修复原轮询逻辑的自旋与死锁问题
    将networkTask的下行音频发送从1ms轮询改为由audioTask入队帧触发通知唤醒，无待发送帧时以5ms轮询兜底，大幅降低空轮询开销
    统一并完善DebugStats与Pacer的调试统计注释，修正不同计数的口径差异
    调整networkTask任务优先级至3，避免抢占音频任务
    简化pacer周期配置逻辑，优化轮询档位设置
    修正queuePopFail的计数逻辑，仅在通知唤醒空队列时计数
    清理队列时同步清除残留任务通知，修复竞态问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
    [main.cpp]
2026-11-01 feat(esp32s3): 实现非阻塞UDP并优化WiFi与调试统计
    新增NonBlockingUdp类封装非阻塞UDP socket操作，替换原有的阻塞式WiFiUDP实现。添加定期WiFi状态快照机制，缓存连接状态、本地IP与RSSI值，优化状态LED的闪烁逻辑。扩展调试统计功能，新增USB TX FIFO最大可用空间统计项，重构统计辅助函数以支持int32类型的极值统计。完善网络任务的错误处理流程，适配非阻塞UDP的读写与发送场景，更新调试打印的字段说明与展示内容。
2026-11-01 refactor(esp32s3): 拆分独立编码任务并优化网络与调试逻辑
    拆分出独立的encoderTask处理Opus音频编码，将编码工作从networkTask剥离，降低网络任务的CPU负载，同时调整Opus编码器复杂度为0以优先保证实时性
    改进NonBlockingUdp工具类，新增lastError()方法获取详细的套接字错误码，优化错误判断与处理逻辑，新增ENOMEM的临时阻塞判断
    扩展调试统计结构体，新增网络各阶段耗时、错误重置次数、发送错误码等细分统计项
    新增串口输出宏LANMIC_ENABLE_SERIAL，支持一键关闭调试打印以适配现场部署场景
    优化下行音频队列管理，限制单轮循环的发包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
2026-11-01 perf(vst3/transport): 优化音频传输队列与发送逻辑
    扩大出站环形队列容量从32增至64，提升缓冲能力；调低Opus编码器复杂度至5，减少编码阶段的CPU占用；重构上行音频发送逻辑，新增旧包超时丢弃机制，限制最大回退队列长度为32帧，控制单次发送帧数与发送间隔，避免突发流量压垮下游套接字缓冲区。
2026-11-02 feat: 添加接收诊断UI，统一上下行码率，修复编译配置
    为VST3接收插件添加诊断面板，显示接收统计信息，包括包数、缓冲时长、PLC补偿次数、迟到包、解码错误等，根据插件类型动态显示/隐藏该面板。
    将上下行Opus码率统一为192kbps，修正协议文档中的对应描述。
    更新ESP32 PlatformIO编译配置，锁定Arduino 3.1.1对应的平台版本，修复内存类型配置与编译宏。
    优化音频缓冲队列，调整缓冲容量与目标缓冲时间，修复淡入淡出算法与溢出计数逻辑。
    新增接收端统计计数器，修复USB音频后端与任务栈配置。
    更新项目文档与README，删除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
    [AudioBuffer.h, PluginEditor.cpp, PluginEditor.h, Protocol.h, Transport.cpp, Transport.h, main.cpp]
2026-11-02 refactor(esp32s3): 重构main.cpp，简化重复逻辑并优化注释
    合并statsMax的两个重载函数为模板函数减少代码冗余
    提取resetSockets和invalidateReceiver两个lambda函数简化networkTask重复代码
    移除未使用的S_FLUSH串口宏定义
    调整encoderTask的任务通知逻辑简化代码分支
    优化多处代码注释，统一表述并修正过时内容
    [main.cpp]
2026-11-02 feat: 新增设备远程诊断功能，优化构建与任务配置
    - 新增SOS协议的Diagnostics诊断包类型，定义设备诊断数据结构与编解码函数
    - 更新VST3插件的UI布局、诊断显示逻辑与提示文案
    - 为ESP32-S3固件添加周期性诊断包发送功能，新增各类性能与状态统计指标
    - 调整ESP32-S3的PlatformIO Flash内存配置为qio_qspi适配硬件
    - 优化任务绑定核心与优先级配置，平衡多任务负载
    - 默认关闭串口调试输出，降低固件资源占用
    - 更新PROTOCOL.md文档，补充诊断包的协议说明与使用指南
2026-11-02 docs(comments, scripts): 将中文注释替换为英文注释，统一项目注释语言
    涵盖ESP32固件主代码、全平台VST插件安装与打包脚本，同步更新脚本的用法、说明等文档内容为英文，优化部分技术描述的准确性与可读性。
2026-11-02 功能: 添加诊断信息清零功能, 更新文档与编辑器UI
    修订协议文档补充面板手动清零清除基线的说明, 新增诊断计数器重置相关方法, 为插件编辑器添加清零按钮与面板切换功能, 重构UI布局与样式, 修复编辑器析构时LookAndFeel未正确释放的问题, 更新诊断显示的提示文本与逻辑
    [AudioBuffer.h, PluginEditor.cpp, PluginEditor.h, Transport.cpp, Transport.h]
2026-11-02 feat: 实现双向全链路立体声Opus音频传输
    升级协议至v9，统一上下行均为立体声Opus编码，移除单声道上行相关配置；更新VST3插件与ESP32设备端的音频处理逻辑，适配新的立体声帧格式；同步更新文档与网页说明，修正所有单声道相关的描述内容。
2026-11-02 refactor(esp32s3): 拆分 main.cpp
2026-11-03 refactor: 调整缓冲配置，修复多处bug并新增日志功能
    将设备端与Return插件的目标音频缓冲统一为300ms，同步更新README文档与AudioBuffer.h的配置项
    修复VST3编辑器版权文本的点击区域bug，将点击范围调整为匹配文本实际宽度以避免误触发
    为VST3传输模块添加可选的文件日志功能，默认处于关闭状态，运行状态将写入用户文档目录的LANMIC子文件夹
    重构ESP32端的非阻塞UDP网络逻辑，移除冗余的select轮询步骤，改用socket自身的错误码判断读写状态以降低延迟
    优化PLC丢包隐藏逻辑，限制每轮处理的隐藏帧数量以避免任务过载；重构统计变量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
    [AudioBuffer.h, NetworkTask.cpp, NonBlockingUdp.h, PluginEditor.cpp, Transport.cpp]
2026-11-03 chore(site): 更新发布资源至v0.1.1并修改下载链接
    新增macOS和Windows的v0.1.1安装包，删除旧版0.1.0的pkg安装文件，更新首页下载链接，同时更新两张功能展示图片
2026-11-09 feat(enclosure): 新增PCB1的FDM打印外壳设计与相关文档
    添加参数化外壳生成脚本docs/enc_build.py，支持基于PCB模型生成免螺丝粘接的FDM打印外壳；更新README补充外壳设计说明、参数规范与使用方法，新增enclosure目录存储生成的FreeCAD模型文件。
    [3D_PCB1_2026-11-09.obj, PCB1_enclosure.FCStd]
2026-11-10 refactor(enclosure): 移动模型位置
    [3D_PCB1_2026-11-09.obj]
2026-11-10 refactor: 清理调试统计与诊断代码，更新音频库依赖
    - 移除全部Stats统计相关的头文件、实现与上报逻辑
    - 删除WiFi RSSI跟踪的全局变量与对应统计代码
    - 移除设备诊断的协议支持、网络传输逻辑与插件UI诊断面板
    - 简化Pacer、AudioBuffer等类的成员与逻辑，移除冗余计数器
    - 删除未使用的audioTaskHandle全局变量
    - 将arduino-audio-tools依赖更新至v1.3.0版本
2026-11-10 refactor(esp32s3): 重构串口与USB音频逻辑，更新依赖与配置
    - 删除旧的Log.h，新增Serial.h统一管理串口输出，替换所有S_*宏为SERIAL_*系列宏
    - 使用USB CDC作为串口输出，适配复合USB音频+串口设备
    - 移除自定义USB音频音量、静音处理逻辑，改用arduino-audio-tools v1.3.0内置能力
    - 调整USB音频配置：修改fifo包数从48为32，启用内置音量控制
    - 调整networkTask运行核心从Core1迁移至Core0，优化任务调度
    - 更新README文档：修正依赖版本、安装包占位符与PCB模型描述
    - 清理冗余调试打印，简化任务创建与USB流状态检测逻辑
    [AudioTasks.cpp, NetworkTask.cpp, Serial.h, UsbAudio.cpp, UsbAudio.h, main.cpp]
2026-11-10 perf(esp32s3/audio): 优化音频捕获缓冲区性能并调整日志格式
    - 将captured帧环形缓冲区从AudioQueues移至全局BSS变量，避免PSRAM访问的106us推送延迟，适配1ms tick要求
    - 为所有串行打印添加[D]前缀，统一标记为调试日志
    - 修复lastUplinkMs加载的内存序配置问题
    [AudioTasks.cpp, AudioTasks.h, NetworkTask.cpp, main.cpp]
2026-11-11 perf(audio buffer): 优化音频缓冲区延迟修剪逻辑避免延迟攀升
    新增高水位修剪阈值替代原有trimMargin的计算方式，添加详细注释说明网络抖动下延迟持续攀升的问题，同时新增静态断言确保高水位阈值不超过队列容量
    [AudioBuffer.h]
2026-11-11 feat: 添加设备自定义名称与配置功能
    1. 升级SOS网络协议至v10，修改Discover应答负载为`设备标识|设备显示名称`格式
    2. 为VST3插件新增设备显示名称支持，设备列表下拉框展示用户可修改的名称，仍以设备标识保存连接偏好
    3. 新增串口控制台与Web配置界面，支持修改设备名称、开关音频通道、清除WiFi凭据等操作
    4. 修复USB CDC打印阻塞音频任务的问题，实现带流量控制的串口输出逻辑
    5. 更新文档与网站导航链接，补充协议说明与配置使用教程
    [Console.cpp, Console.h, NetworkTask.cpp, PluginEditor.cpp, PluginEditor.h, Protocol.h, Serial.h, Transport.cpp]
2026-11-11 feat: 整合多项功能优化与bug修复
    - 新增common/Version.h作为全项目统一的版本号来源，修复多位置版本不一致的问题
    - 更新vst3插件、打包脚本、官网及固件的版本读取逻辑，全部从该文件获取版本信息
    - 重构ESP32-S3的CDC串口实现，将串口缓冲逻辑从main.cpp迁移至Serial.cpp，修复串口死锁与FIFO溢出问题，优化轮询间隔避免阻塞USB音频任务
    - 新增restartUsbAudio函数，实现音频端点切换后自动重置USB音频，主机短暂重连即可生效，无需重启设备
    - 优化控制台命令：支持UTF-8设备名，调整ep命令行为，设置端点后自动触发USB重置，无需重启设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
    [Console.cpp, Console.h, PluginEditor.h, Serial.cpp, Serial.h, Transport.cpp, Version.h, main.cpp]
2026-11-13 fix(esp32s3): 修复usb音频音量控制异常，添加自动补丁脚本
    解决macOS系统下主机麦克风输入滑块误修改播放音量的问题：
    - 分离麦克风与播放路径的独立音量状态，修复audio-tools库的共享状态bug
    - 新增PlatformIO自动补丁脚本，每次依赖安装后自动修补库代码
    - 在音频采集任务中应用主机设置的麦克风增益参数处理采集样本
    [AudioTasks.cpp]
2026-11-13 feat(web,firmware,scripts): 发布LAN MIC v1.0.0正式版本
    新增固件构建与站点部署自动化脚本，完善web端设备配置页面，支持浏览器直连设备、参数调整与固件更新。更新README文档的版本示例，新增v1.0.0版本的ESP32-S3固件文件与配套配置。
2026-11-13 feat: 替换网页固件更新器为自定义 esptool-js 实现，更新固件与优化代码
    - 替换原 esp-web-tools 组件为自定义 esptool-js 固件更新逻辑，添加进度显示与中文提示
    - 移除外部 CDN 依赖，优化串口端口选择过滤
    - 调整串口打印宏，同时输出到 cdcSerial 和 Serial 设备
    - 优化控制台 erase 命令的 WiFi 凭据擦除流程
    - 更新固件二进制文件与配套的 manifest 配置文件
2026-11-13 fix(esp32s3): 预先分配Opus解码器内存并静态创建网络/音频任务
    之前在网络任务中分配Opus解码器内存会因Wi-Fi配置后的堆碎片化失败，改为在setup阶段提前分配；同时将网络和音频任务改用静态创建，避免动态任务创建失败时静默运行。
2026-11-13 fix(esp32s3/audio-tools): 修复macOS音量键无法正确调整麦克风音量的问题
    调整音量转换为真实分贝计算，将音量范围分辨率改为1/256 dB，添加麦克风功能单元音量日志
2026-11-13 fix(esp32s3): 修复音频任务栈溢出和串口printf递归问题
    音频任务栈扩容至16KB解决USB播放链路栈溢出，替换串口打印函数避免递归触发栈金丝雀检查
2026-11-13 chore: 更新PCB外壳参数、修复路径、网站样式及新增资源文件
    [PCB1_enclosure.3mf, PCB1_enclosure.FCStd]
2026-11-13 build(version): 移除版本号'v'前缀并同步相关文件
    - 更新Version.h，版本号去掉'v'前缀以适配解析脚本需求
    - 调整站点版本比较逻辑的注释说明
    - 更新下载文件名及脚本中的版本常量
2026-11-13 build(Windows安装器): 重命名安装器文件名并更新相关引用
2026-11-14 feat(enclosure): 添加按键针孔及天线压合结构
    [PCB1_enclosure.3mf, PCB1_enclosure.FCStd]
